cbkillion/SDTx/README.md

# SDTx
Software Defined Transmitter using the STM32
