cbkillion/SDTx/BOM.xlsx

# | RefDes | Value | Quantity | Name | Digikey # | Cost | Total Cost | Qty Ordered | Cost @ Qty | Order Cost
1 | C1, C6, C8, C9, C10, C11, C12, C13, C14, C15, C16, C17, C20, C21, C22, C23, C24, C27, C28, C29, C30, C35, C37, C38, C39, C44, C45, C48, C49, C50 | .1uF | 30 | CAP_0603 | 1276-1005-1-ND | $0.02 | $0.60 | 500 | $0.003 | $1.50
2 | C2, C3, C4 | 22uF | 3 | CAP_0603 | 1276-2868-1-ND | $0.02 | $0.06 | 25 | $0.13 | $3.31
3 | C5, C36 | 10uF | 2 | CAP_0603 | 490-10470-1-ND | $0.02 | $0.04 | 25 | $0.07 | $1.74
4 | C7 | 10nF | 1 | CAP_0603 | 1276-1927-1-ND | $0.02 | $0.02 | 25 | $0.01 | $0.15
5 | C18 | 4.7uF | 1 | CAP_0603 | 1276-2087-1-ND | $0.02 | $0.02 | 25 | $0.05 | $1.31
6 | C19 | 1uF | 1 | CAP_0603 | 1276-1034-1-ND | $0.02 | $0.02 | 25 | $0.02 | $0.39
7 | C25, C26 | 2.2uF | 2 | CAP_0603 | 1276-1085-1-ND | $0.02 | $0.04 | 25 | $0.03 | $0.74
8 | C31 | 47nF | 1 | CAP_0603 | 1276-2078-1-ND | $0.02 | $0.02 | 25 | $0.01 | $0.36
9 | C32, C33 | 560pF | 2 | CAP_0603 | 1276-1278-1-ND | $0.02 | $0.04 | 25 | $0.01 | $0.22
10 | C34 | 1.2nF | 1 | CAP_0603 | 1276-2184-1-ND | $0.02 | $0.02 | 25 | $0.01 | $0.29
11 | C40, C41, C51, C52 | 68pF | 4 | CAP_0603 | 1276-1135-1-ND | $0.02 | $0.08 | 50 | $0.01 | $0.52
12 | C42, C43, C46, C47 | 1nF | 4 | CAP_0603 | 1276-1018-1-ND | $0.02 | $0.08 | 50 | $0.01 | $0.46
13 | D1, D2, D3, D4, D5 | LED | 5 | DIODE_0603 | 160-1434-1-ND | $0.10 | $0.50 | 50 | $0.13 | $6.74
14 | J1 | USB Conn | 1 | 67503-1020 | WM5461CT-ND | $1.13 | $1.13 | 4 | $1.13 | $4.52
15 | J2 | Power Conn | 1 | PJ-002AH-SMT | CP-002AHPJCT-ND | $1.89 | $1.89 | 4 | $1.89 | $7.56
16 | J3 | Power Selector | 1 | JUMPER_3 | S9000-ND | $0.10 | $0.10 | 10 | $0.08 | $0.77
17 | J4 | ST-Link | 1 | 1986717-6 | 277-1753-ND | $0.40 | $0.40 | 4 | $1.60 | $6.40
18 | J5 | BNC Conn | 1 | 73137-5003 | WM5514-ND | $2.15 | $2.15 | 4 | $2.15 | $8.60
19 | L1 | 6uH | 1 | NR6028T | 587-2101-1-ND | $0.40 | $0.40 | 4 | $0.40 | $1.60
20 | L2, L3, L4, L5 | 2.2uH | 4 | IND_0603 | 535-11597-1-ND | $0.05 | $0.20 | 25 | $0.08 | $1.91
21 | R1 | 100k | 1 | RES_0603 | 311-100KHRCT-ND | $0.02 | $0.02 | 10 | $0.01 | $0.14
22 | R2 | 40.2k | 1 | RES_0603 | 311-40.2KHRCT-ND | $0.02 | $0.02 | 10 | $0.01 | $0.14
23 | R3 | 75k | 1 | RES_0603 | 311-75.0KHRCT-ND | $0.02 | $0.02 | 10 | $0.01 | $0.14
24 | R4 | 7.68k | 1 | RES_0603 | 311-7.68KHRCT-ND | $0.02 | $0.02 | 10 | $0.01 | $0.14
25 | R5, R12, R13 | 2k | 3 | RES_0603 | 311-2.00KHRCT-ND | $0.02 | $0.06 | 25 | $0.01 | $0.25
26 | R6, R7 | 10k | 2 | RES_0603 | 311-10.0KHRCT-ND | $0.02 | $0.04 | 25 | $0.01 | $0.25
27 | R8, R9, R10, R11 | 1k | 4 | RES_0603 | 311-1.00KHRCT-ND | $0.02 | $0.08 | 25 | $0.01 | $0.25
28 | R14, R15 | 160 | 2 | RES_0603 | 311-160HRCT-ND | $0.02 | $0.04 | 25 | $0.01 | $0.25
29 | R16 | 150 | 1 | RES_0603 | 311-150HRCT-ND | $0.02 | $0.02 | 10 | $0.01 | $0.14
30 | R17, R18, R19, R20, R23, R25, R26, R27, R28, R30, R31 | 100 | 11 | RES_0603 | 311-100HRCT-ND | $0.02 | $0.22 | 100 | $0.01 | $0.57
31 | R21, R22 | 51 | 2 | RES_0603 | 311-51.0HRCT-ND | $0.02 | $0.04 | 25 | $0.01 | $0.25
32 | R24 | 75 | 1 | RES_0603 | 311-75.0HRCT-ND | $0.02 | $0.02 | 10 | $0.01 | $0.14
33 | R29 | 4.7K | 1 | RES_0603 | 311-4.70KHRCT-ND | $0.02 | $0.02 | 10 | $0.01 | $0.14
34 | S1, S2, S3 | Switch | 3 | B3U-1000P | SW1020CT-ND | $1.25 | $3.75 | 12 | $1.20 | $14.41
35 | U1 | Switching Reg | 1 | AP65201 | AP65201WU-7DICT-ND | $0.58 | $0.58 | 10 | $0.51 | $5.10
36 | U2 | DAC | 1 | AD9761ARS | AD9761ARSZ-ND | $18.45 | $18.45 | 0 | $18.45 | $0.00
37 | U3 | Microcontroller | 1 | STM32F405RGT | 497-11767-ND | $10.58 | $10.58 | 4 | $10.58 | $42.32
38 | U4 | Clock Gen | 1 | Si5351A-B-GT | 336-2399-5-ND | $0.92 | $0.92 | 5 | $0.92 | $4.60
39 | U5 | Linear Reg | 1 | LD1117S33CTR | 497-1241-1-ND | $0.46 | $0.46 | 10 | $0.37 | $3.73
40 | U6 | Quad Mod | 1 | ADRF6755ACPZ | ADRF6755ACPZ-R7CT-ND | $16.90 | $16.90 | 0 | $16.90 | $0.00
41 | U7 | Amplifier | 1 | GALI-3+ | MiniCircuits GALI-3+ | $1.00 | $1.00 | 20 | $0.99 | $19.80
42 | X1 | 25MHz | 1 | ECS-TXO-3225 | XC2062CT-ND | $2.71 | $2.71 | 5 | $2.71 | $13.55
 |  |  | 109 |  |  |  | $63.78 |  |  | $155.40
