cbkillion/SDTx/(list of files, drawings)

Other design files:
SDR_Transmitter.dch
SDR_Transmitter.dip
