cbkillion/SDTx/(commit log)

2016-06-09 Split 200 Ohm resistors into two 100 Ohms.
    [SDR_Transmitter.dch]
2016-06-10 Started to flesh out the uC.
    [SDR_Transmitter.dch]
2016-06-10 Continued working on the uC and now the DAC.
    [SDR_Transmitter.dch]
2016-06-15 Resorted modulator REGOUT decoupling caps.
    [SDR_Transmitter.dch]
2016-06-16 Added word dovument with DAC filter circuit simulation results.
2016-06-16 A bit more progress to schematic, nothing big.
    [SDR_Transmitter.dch]
2016-06-28 Minor changes including placing TCXO for Si5351.
    [SDR_Transmitter.dch]
2016-07-08 Added an attenuator and amplifier to the output of the modulator.
    [SDR_Transmitter.dch]
2016-07-12 Added TCXO, hooked up I2C lines, hooked up SWD connections, added datasheets for TCXO and Si5351.
    [SDR_Transmitter.dch]
2016-07-13 Added DC jack.
    [SDR_Transmitter.dch]
2016-07-15 Very minor changes, nothing of note.
    [SDR_Transmitter.dch]
2016-07-18 Rearranged schematics and started working on power supplies.
    [SDR_Transmitter.dch]
2016-07-20 Added switching regulator datasheet. Started populating switching regulator.
    [SDR_Transmitter.dch]
2016-07-27 Changed the page size and displayed part values.
    [SDR_Transmitter.dch]
2016-08-02 Added 5V and 3V3 regulators.
    [SDR_Transmitter.dch]
2016-08-02 Added BoM. Added BNC connector and other tidying up.
    [SDR_Transmitter.dch]
2016-08-04 Connected third clock output to uC.
    [SDR_Transmitter.dch]
2016-08-04 Generated PCB and started placing parts.
    [SDR_Transmitter.dip]
2016-08-04 Random stuff, no real progress.
    [SDR_Transmitter.dip]
2016-08-11 Added two additional LEDs just because LEDs.
    [SDR_Transmitter.dch]
2016-08-11 Renumbered parts to make sense after moving and adding some.
    [SDR_Transmitter.dch]
2016-08-11 Started laying out PCB.
    [SDR_Transmitter.dch, SDR_Transmitter.dip]
2016-08-12 Grouped components onto board.
    [SDR_Transmitter.dch, SDR_Transmitter.dip]
2016-08-13 Changed jelly bean parts to 0603. Redid biasing on amp.
    [SDR_Transmitter.dch]
2016-08-13 Made sure BOM was updated.
    [SDR_Transmitter.dch]
2016-08-13 Updated inductors to 0603 also...
    [SDR_Transmitter.dch]
2016-08-16 More layout and a few schematic changes.
    [SDR_Transmitter.dch, SDR_Transmitter.dip]
2016-08-16 Changed amplifier to GALI-3+, added resistor to QuadMod RefIn.
    [SDR_Transmitter.dch]
2016-08-16 Started routing traces.
    [SDR_Transmitter.dip]
2016-08-18 More trace routing.
    [SDR_Transmitter.dip]
2016-08-19 More routing.
    [SDR_Transmitter.dip]
2016-09-02 Completed routing of all nets besides ground.
    [SDR_Transmitter.dip]
2016-09-02 Added ground plane to layer 1.
    [SDR_Transmitter.dip]
2016-09-22 Connected ground net with pours and vias. Ready for exporting Gerbers?
    [SDR_Transmitter.dip]
2016-09-23 Created gerbers, updated .gitignore to exclude *.zip. This is Rev 0 that was sent to Elecrow!
    [SDR_Transmitter.GBL, SDR_Transmitter.GBO, SDR_Transmitter.GBP, SDR_Transmitter.GBS, SDR_Transmitter.GTL, SDR_Transmitter.GTO, SDR_Transmitter.GTP, SDR_Transmitter.GTS]
2016-09-23 Added BOM in excel with Digikey parts and one-off costs.
    [BOM.xlsx]
2016-09-27 Added Digikey part numbers to everything and put in how many I will order and what the volume prices are.
    [BOM.xlsx]
2016-10-05 Added GALI-3+ part number and costs to BOM.
    [BOM.xlsx]
2016-11-17 Made changes to the schematic to correct errors made in v0.
    [SDR_Transmitter.dch]
2016-11-17 Updated the BOM to include previous commit's changes.
    [SDR_Transmitter.dch]
2016-12-08 Added text file of changes to make for Rev1.
    [SDR_Transmitter.dch]
2016-12-08 Started laying out Rev1.
    [SDR_Transmitter.dch, SDR_Transmitter.dip]
2017-01-25 More updates to the schematic.
    [SDR_Transmitter.dip]
2017-01-26 Still more PCB layout.
    [SDR_Transmitter.dip]
2017-02-27 Simply pushing to get everything up to speed.
    [SDR_Transmitter.dch, SDR_Transmitter.dip]
2017-02-28 Put test points on MuxOut and ExtTrig. Removed BNC for 1PPS external trigger.
    [SDR_Transmitter.dch]
2017-03-22 Another commit to get synced up.
    [SDR_Transmitter.dch, SDR_Transmitter.dip]
2017-03-31 Committing as a possible release candidate!
    [SDR_Transmitter.dch, SDR_Transmitter.dip]
2017-04-11 Exported new gerbers for Version 2. This commit is what was sent to the fab!
    [SDR_Transmitter.GBL, SDR_Transmitter.GBS, SDR_Transmitter.GTL, SDR_Transmitter.GTO, SDR_Transmitter.GTP, SDR_Transmitter.GTS]
2017-04-13 Made sure the BOM reflected the schematic.
    [SDR_Transmitter.dch]
